akadamson/APRS-Mini-Tracker/README.markdown

APRS Mini Tracker - Arduino
========================================

Version 1.01 Schematics released
  * added the eagle files
  * added PDF of schematics

Version 1.0 Release Notes (8/16/2011)
----------------------------------------
  * initial checkin and creation of repo
