akadamson/APRS-Mini-Tracker/Schematics/Digi-Key - Bill of Materials.pdf

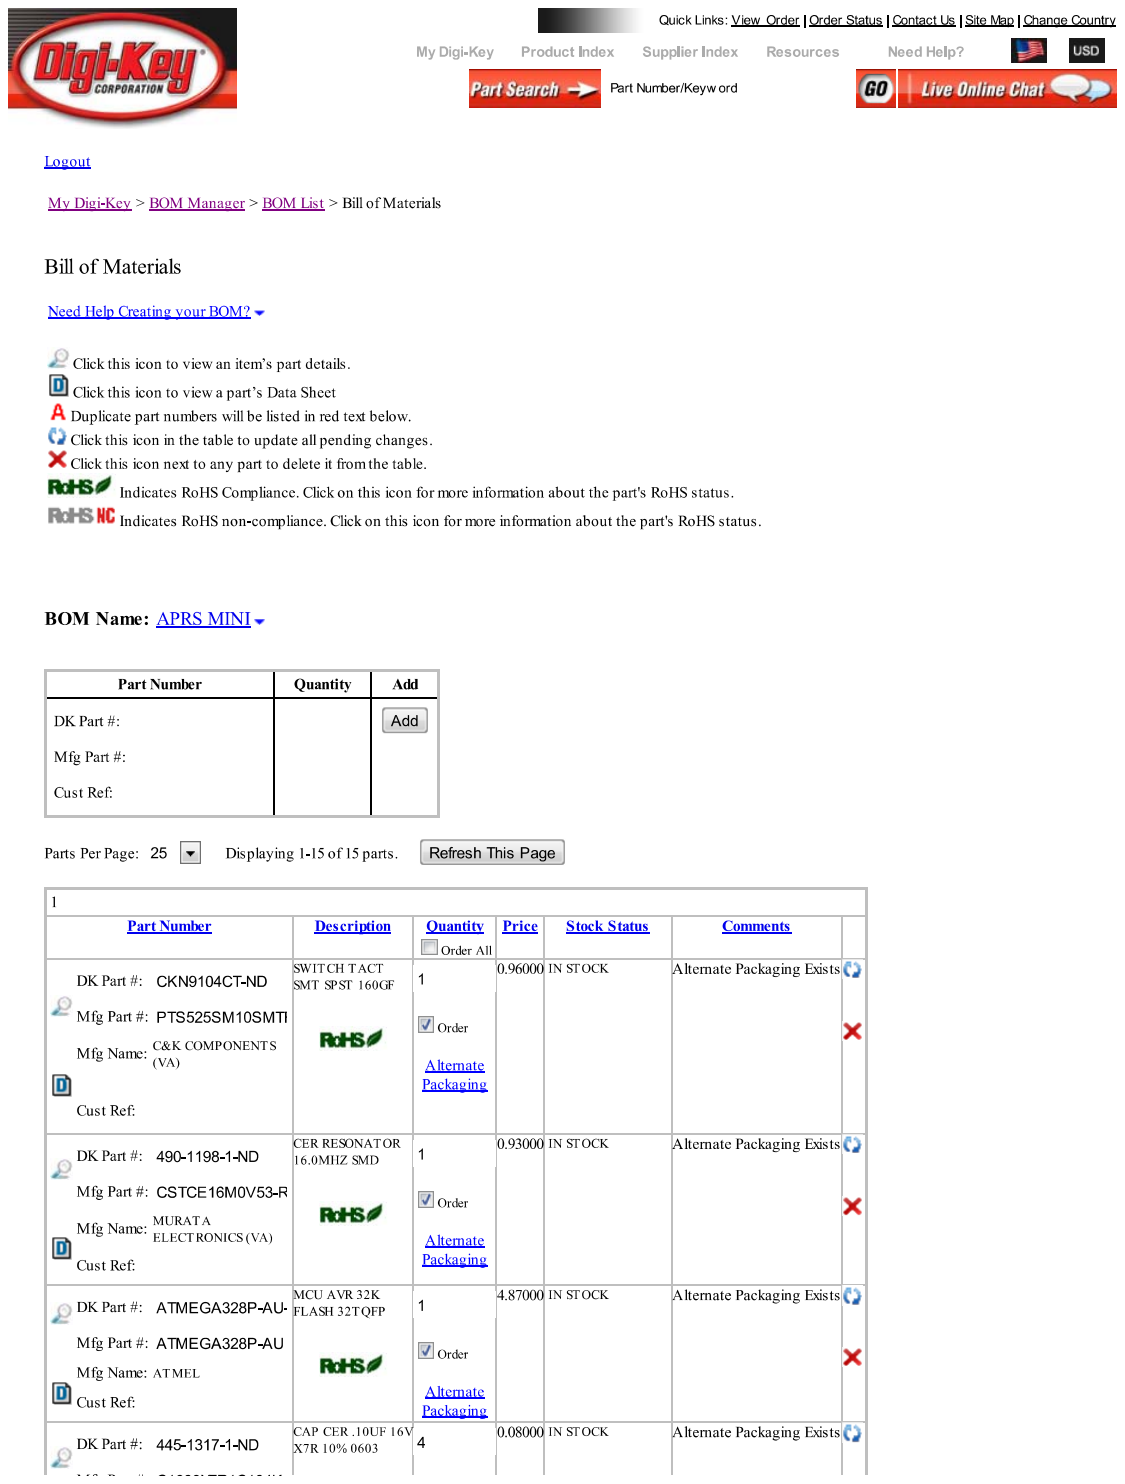
[picture p1: page 1]

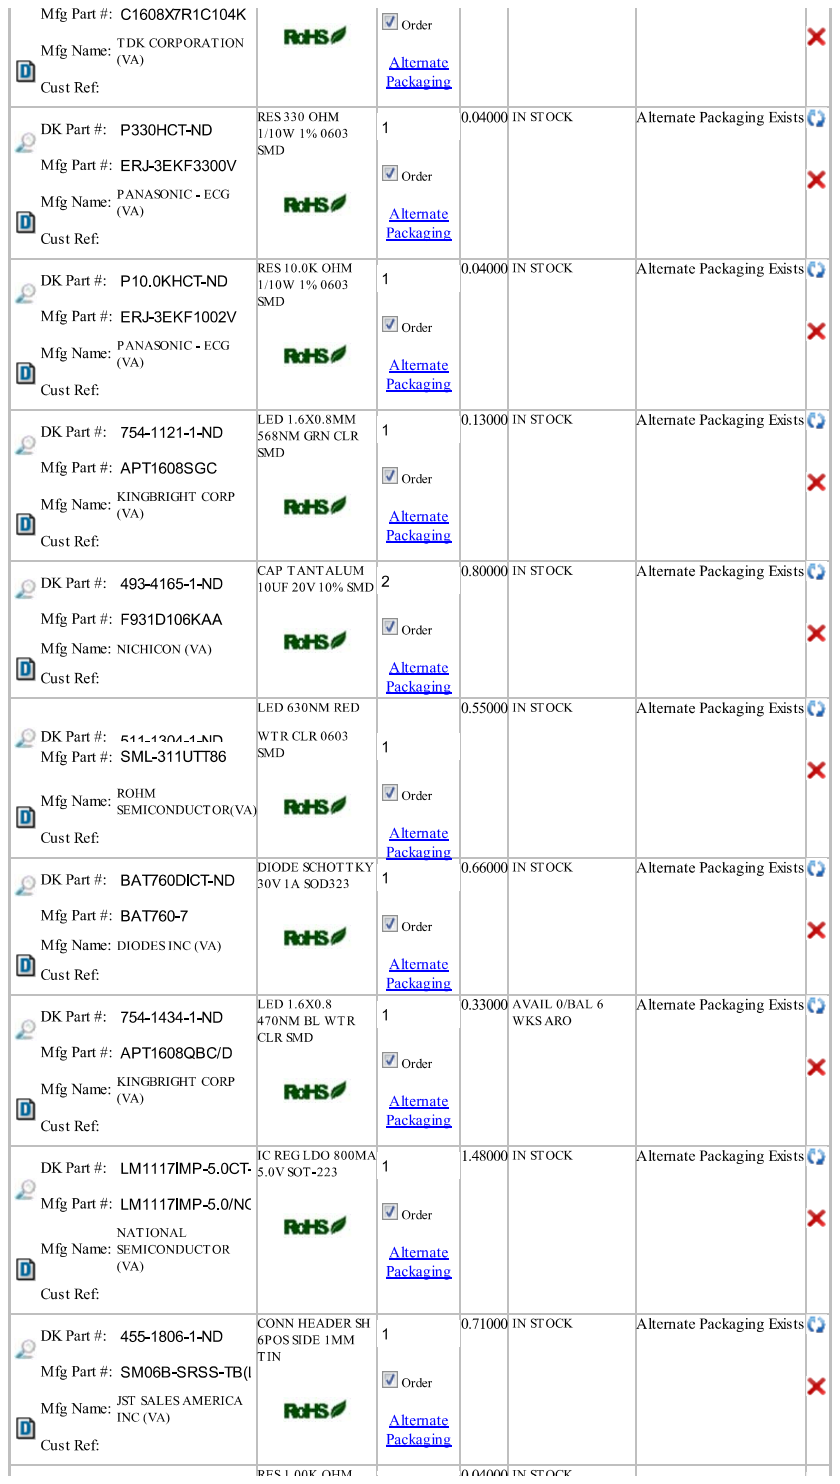
[picture p2: page 2]

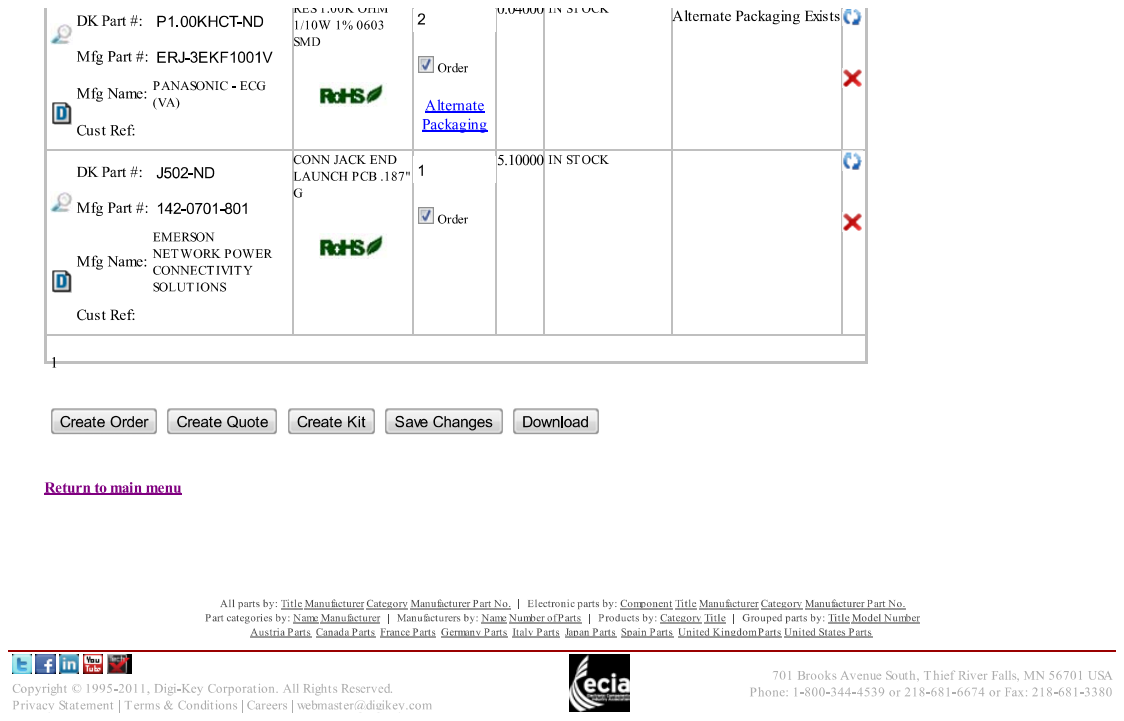
[picture p3: page 3]
