akadamson/APRS-Mini-Tracker/Schematics/APRS Mini.pdf

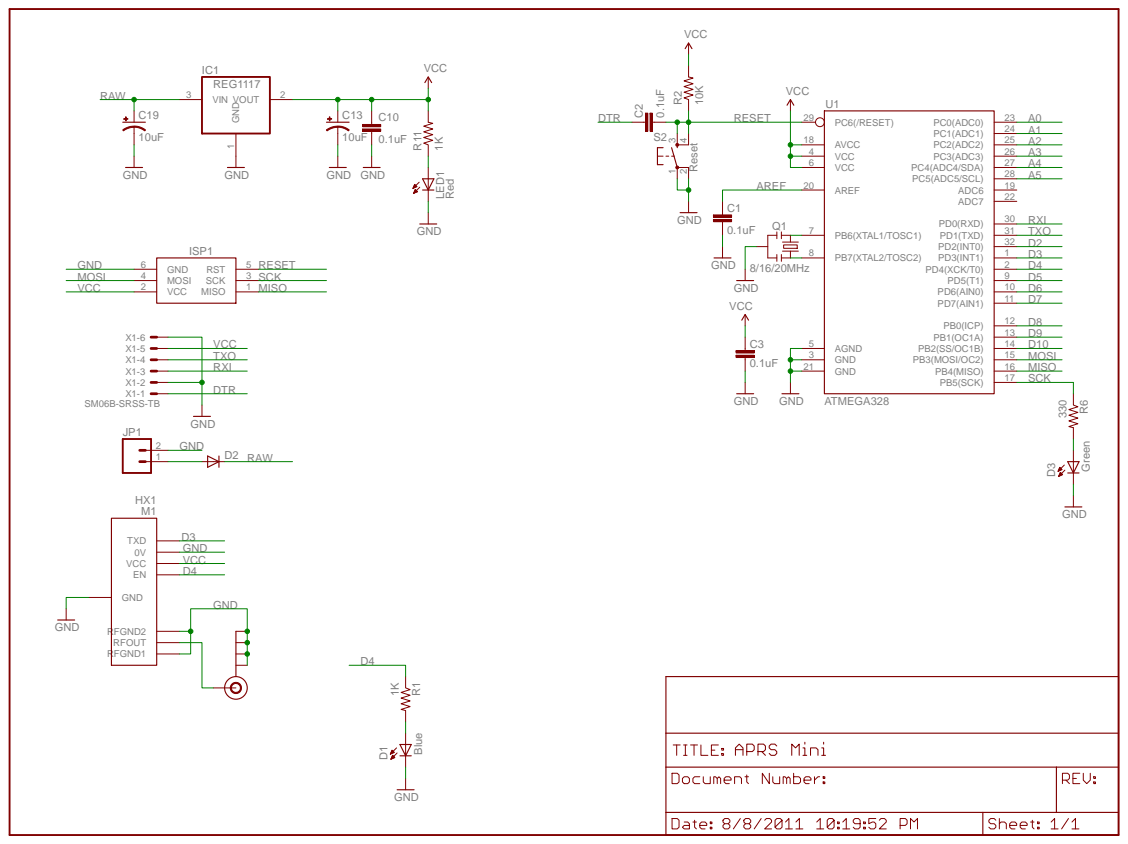
[picture p4: page 1]
