akadamson/APRS-Mini-Tracker/trackuino.pde

/* trackuino copyright (C) 2010  EA5HAV Javi
 *
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
 * You should have received a copy of the GNU General Public License
 * along with this program; if not, write to the Free Software
 * Foundation, Inc., 51 Franklin Street, Fifth Floor, Boston, MA  02110-1301, USA.
 */

// Refuse to compile on arduino version 21 or lower. 22 includes an 
// optimization of the USART code that is critical for real-time operation.
#if ARDUINO < 22
#error "Oops! We need Arduino 22 or later"
#endif

// Trackuino custom libs
#include "aprs.h"
#include "ax25.h"
//#include "buzzer.h"
#include "config.h"
#include "debug.h"
#include "gps.h"
#include "modem.h"
#include "radio.h"
#include "radio_hx1.h"
#include "radio_mx146.h"
//#include "sensors.h"

// Arduino/AVR libs
#include <Wire.h>
#include <WProgram.h>
#include <avr/power.h>
#include <avr/sleep.h>

unsigned long next_tx_millis;

void disable_bod_and_sleep()
{
  /* This will turn off brown-out detection while
   * sleeping. Unfortunately this won't work in IDLE mode.
   * Relevant info about BOD disabling: datasheet p.44
   *
   * Procedure to disable the BOD:
   *
   * 1. BODSE and BODS must be set to 1
   * 2. Turn BODSE to 0
   * 3. BODS will automatically turn 0 after 4 cycles
   *
   * The catch is that we *must* go to sleep between 2
   * and 3, ie. just before BODS turns 0.
   */
  unsigned char mcucr;

  cli();
  mcucr = MCUCR | (_BV(BODS) | _BV(BODSE));
  MCUCR = mcucr;
  MCUCR = mcucr & (~_BV(BODSE));
  sei();
  sleep_mode();    // Go to sleep
}

void power_save()
{
  /* Enter power saving mode. SLEEP_MODE_IDLE is the least saving
   * mode, but it's the only one that will keep the UART running.
   * In addition, we need timer0 to keep track of time, timer 1
   * to drive the buzzer and timer2 to keep pwm output at its rest
   * voltage.
   */

  set_sleep_mode(SLEEP_MODE_IDLE);
  sleep_enable();
  power_adc_disable();
  power_spi_disable();
  power_twi_disable();

  digitalWrite(LED_PIN, LOW);
  sleep_mode();    // Go to sleep
  digitalWrite(LED_PIN, HIGH);
  
  sleep_disable();  // Resume after wake up
  power_all_enable();

}


void setup()
{
  pinMode(LED_PIN, OUTPUT);
  Serial.begin(GPS_BAUDRATE);
#ifdef DEBUG_RESET
  Serial.println("RESET");
#endif
  modem_setup();
//  buzzer_setup();
//  sensors_setup();
  gps_setup();

  // Schedule the next transmission within APRS_DELAY ms
  next_tx_millis = millis() + APRS_DELAY;
}

void loop()
{
  int c;

  if (millis() >= next_tx_millis) {
    // Show modem ISR stats from the previous transmission
#ifdef DEBUG_MODEM
    modem_debug();
#endif

    aprs_send();
    next_tx_millis = millis() + APRS_PERIOD;
  }
  
  if (Serial.available()) {
    c = Serial.read();
    if (gps_decode(c)) {
//      if (gps_altitude > BUZZER_ALTITUDE)
//        buzzer_off();   // In space, no one can hear you buzz
//      else
//        buzzer_on();
    }
  } else {
    power_save();
  }
}
