akadamson/APRS-Mini-Tracker/(commit log)

2011-08-17 Added the Eagle files, plus the PDF of the Schematics/APRS Mini.brd
    [APRS Mini.brd, APRS Mini.sch]
2011-08-17 Web print of the Digikey BOM, saved as a PDF
