akadamson/APRS-Mini-Tracker/(notices)

Notices in the files:
ax25.cpp:
modify it under the terms of the GNU General Public License
